tungvu-wanderer/banime40-case/README.md

# banime40-case

Low-profile, two-piece, 3D-printed case for the [banime40](https://github.com/ChrisChrisLoLo/banime40) **v2.0** PCB. The plate is part of the top, and the PCB floats between the switches and the tray with no gasket and no PCB screws.

Printed and checked: the corner coupon pair and the full case both fit the real board.

    uv run python case.py     # writes build/

Outputs in `build/`:

| File | What |
|---|---|
| `tray.stl` | bottom piece, printed floor-down |
| `top.stl` | top piece with integrated plate, already flipped to print plate-face-down |
| `case.step` | both parts assembled, for viewing |
| `coupon_tray.stl`, `coupon_top.stl` | top-left corner test pair: pillar, lap joint, USB notch, 2x2 switch holes |

All dimensions live as constants at the top of `case.py`. The frame is the typing (switch-side) view: x right, y up, origin at the PCB's bottom-left corner, z up from the bottom of the tray.

## Measured inputs

Caliper measurements of the real board and hardware. Everything else is derived from these.

| Measurement | Value |
|---|---|
| PCB outline | 190.5 x 76.2 mm (10 x 4 keys at 19.05 mm pitch), corner radius 1.6 mm |
| PCB thickness | 1.6 mm |
| PCB back face to socket tops | 3.55 mm |
| PCB back face to top of Pro Micro + USB-C | 9.05 mm (Pro Micro on a header) |
| Plate top face to PCB back face | 5.15 mm (standard MX switch) |
| USB-C overhang past the PCB edge | 0.5 mm, on the left short edge seen from the switch side |
| USB-C centre | 28.3 mm below the top edge, seen from the switch side (row 2) |
| Brass standoff | round, O3.15 mm |
| Bolt head | O3.7 mm (countersunk flat head, about 1.3 mm tall with a ~0.45 mm cylindrical rim) |

Layout: 4x10 grid, all 40 positions populated. The PCB's six mounting holes, the reset button and the encoders are not used.

## Derived design values

| Value | Result | How |
|---|---|---|
| Tray height | 10.6 mm | 1.2 floor + 0.35 clearance + 9.05 |
| Top height | 5.2 mm | 1.6 plate + 3.6 skirt, so plate top is 5.15-5.2 mm above the PCB back face |
| Total height | 15.8 mm | |
| Outline | 195.6 x 87.6 mm | PCB + 0.3 clearance + 2.55 wall on the short ends; 5.7 mm wall on the long edges |
| Floor | 2.0 mm, 1.2 mm under the Pro Micro | recess is 34.5 mm from the left wall, +-10.5 mm around the USB centre |
| Plate | 1.6 mm | |
| Switch hole | 14.2 x 14.2 mm, plain square | hole size from the stock plate, `banime40/case/stl/Plate Final.stl` |
| USB notch | 13 mm wide, open to the bottom face, up to z = 7.2 mm | |
| Lap joint | 2.0 mm deep, same profile on all four sides | the top's 1.2 mm outer skirt, flush with the tray's outer face, wraps the tray's inner tongue (0.15 mm gap); the tongue is the wall left inside a rabbet 1.35 mm wide. The skirt bottoms out on the rabbet floor, and the tongue top sits 0.2 mm below the seam, so the clearance is hidden inside |
| Pillars | 6, at x = 5, 95.25, 185.5 mm on both long edges, 2.8 mm outside the PCB edge | |
| Pillar tray side | standoff pocket O3.4 mm with its floor at z = 4.0 mm; bolt hole O2.3 mm through the 3.0 mm ledge under it; bottom-face countersink: O4.2 mm straight for 1.0 mm, then a 90 deg cone to the bolt hole |
| Pillar top side | blind slot O3.4 mm, 4.0 mm deep above the seam, 1.2 mm of plate over it; the standoff is glued in | |

All exposed flat faces are multiples of the 0.2 mm layer height.

## Print settings

- PLA, 0.2 mm layers, 0.4 mm nozzle, sparse infill.
- No supports. The tray prints floor-down and the top plate-face-down, which is how the STLs are oriented.
- The bolt countersink opens onto the bed. Its 45 deg wall is self-supporting.

## Hardware

- 6 brass M2 female-female round standoffs, O3.15 mm, 10 mm long. Glued 4.0 mm into the top; the lower end stops 0.6 mm above the tray's pocket floor, so the seam closes before the standoff end does.
- 6 M2 countersunk flat-head bolts (head O3.7 mm), one per pillar, from the bottom face. Length includes the head, which sits about 0.8 mm below the face, so M2x8 gives about 4.2 mm of thread in the standoff.
- Thin rubber feet for the underside. The bolt heads sit about 0.8 mm below the bottom face.

## Assembly

1. Clip the switches into the top's plate holes and seat the PCB on their pins, with the sockets and Pro Micro facing down.
2. Glue each standoff into its slot in the top (thin or medium CA), seated to the bottom of the slot.
3. Close the halves. The top's skirt drops over the tray's tongue.
4. Thread a bolt from the bottom face into each standoff, finger tight.

## Credits

The switch hole size is taken from the stock plate in [ChrisChrisLoLo/banime40](https://github.com/ChrisChrisLoLo/banime40), which is licensed CC BY-SA 4.0.

## License

Copyright (c) 2026 Tung Vu. Licensed under [CC BY-SA 4.0](LICENSE).
