tungvu-wanderer/banime40-case/build/coupon_tray.stl

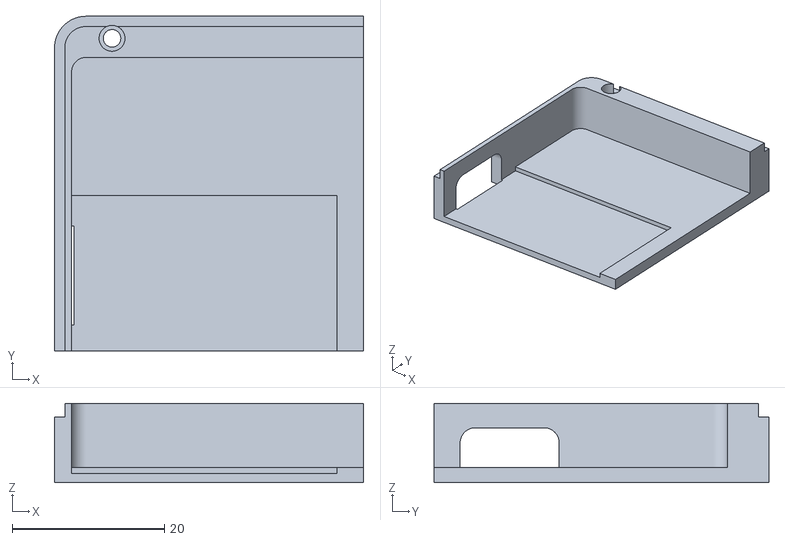
[picture p1: CAD file, 2026-11-10]
build/coupon_tray.stl
40.5 x 43.9 x 10.4
