tungvu-wanderer/banime40-case/build/case.step

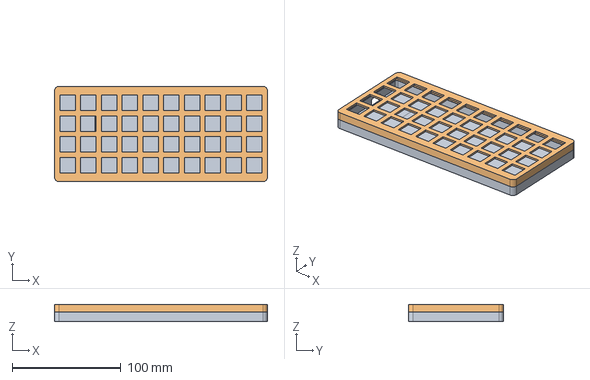
[picture p2: CAD file, 2026-11-10]
build/case.step
195.6 x 87.6 x 15.8 mm
tray
top
