tungvu-wanderer/banime40-case/build/tray.stl

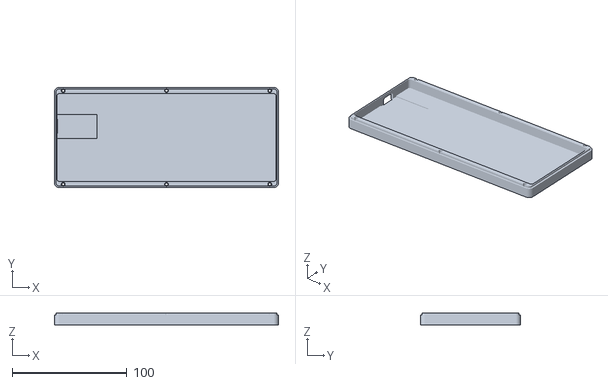
[picture p3: CAD file, 2026-11-10]
build/tray.stl
195.6 x 87.6 x 10.4
