tungvu-wanderer/banime40-case/build/top.stl

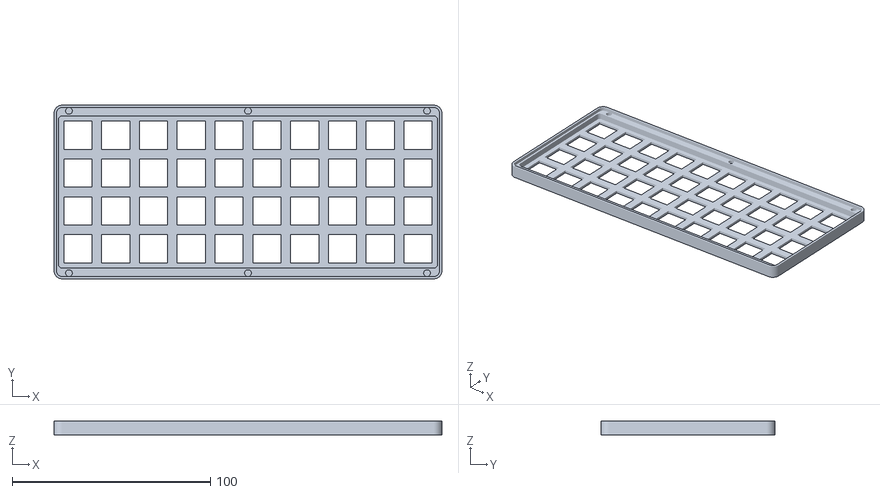
[picture p4: CAD file, 2026-11-08]
build/top.stl
195.6 x 87.6 x 7.20
