tungvu-wanderer/banime40-case/build/coupon_top.stl

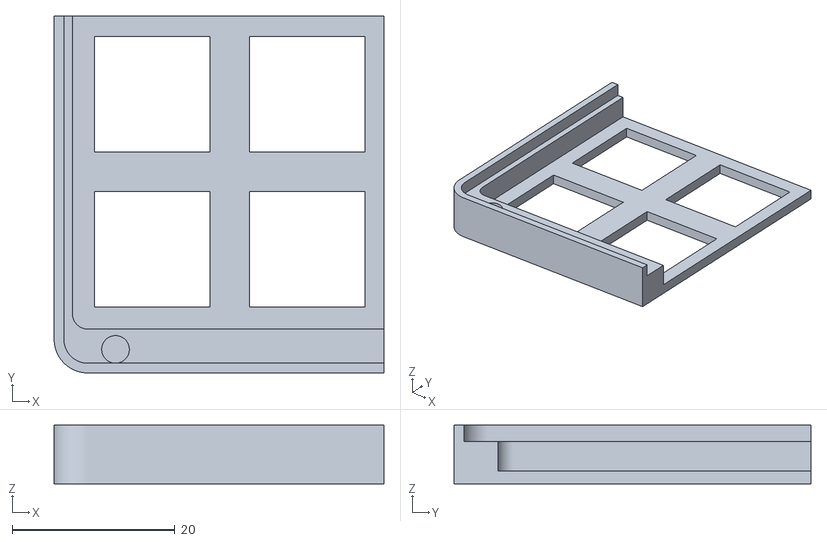
[picture p5: CAD file, 2026-11-08]
build/coupon_top.stl
40.5 x 43.9 x 7.20
