tungvu-wanderer/banime40-case/(commit log)

2026-11-01 Add parametric two-piece case for banime40 v2.0
    [case.step, coupon_top.stl, coupon_tray.stl, top.stl, tray.stl]
2026-11-07 Rework lap, standoff mounting and bolt crater; plain square switch holes
    - Uniform lap on all four sides: top's 1.2 mm outer skirt over the tray's inner tongue
    - Standoffs glued 4.0 mm into blind slots in the top; no top bolts
    - Bolt crater on the bottom face for the flat disk head, with a slit layer before the round hole
    - Plain 14.2 mm square switch holes, no notches
    [case.step, coupon_top.stl, coupon_tray.stl, top.stl, tray.stl]
2026-11-07 Use 10 mm standoffs with a 3.0 mm bolt ledge
    Raise the tray's pocket floor to z = 4.0 so the bolt ledge under each
    pillar is 3.0 mm thick; bolts become M2x8.
    [case.step, coupon_tray.stl, tray.stl]
2026-11-08 Countersunk bolt seat and hidden seam clearance
    - Replace the disk-head crater and slit layer with a 90 deg countersink for M2 flat-head bolts
    - The skirt bottoms out on the rabbet floor; the tongue top sits 0.2 mm below the seam
    [case.step, coupon_top.stl, coupon_tray.stl, top.stl, tray.stl]
2026-11-08 Narrower bolt hole and deeper countersink seat
    - Bolt hole 2.3 mm
    - Countersink: 4.0 mm straight for 0.6 mm, then a 90 deg cone, so the head sits about 0.8 mm below the face
    [case.step, coupon_tray.stl, tray.stl]
2026-11-10 Size the countersink for the bolt head's rim
    Mouth O4.2 mm straight for 1.0 mm before the 90 deg cone, so the O3.7 head
    with its ~0.45 mm rim clears the squished first layers and sits ~0.8 mm
    below the face.
    [case.step, coupon_tray.stl, tray.stl]
